ogruenig/py-alarm/docs/Electronics.png

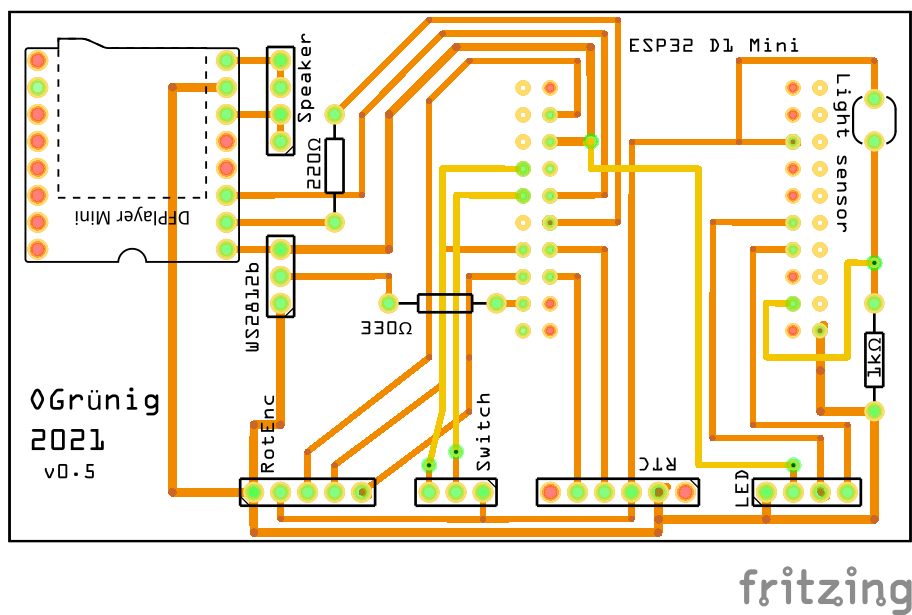
docs/Electronics.png
