ogruenig/py-alarm/(list of files, drawings)

Other design files:
docs/Wiring_Fritzing.fz
